s59mz/PocketSDR-AFS/FE_4CH/HW/v3.0/pocket_sdr_v3.0_sch.pdf

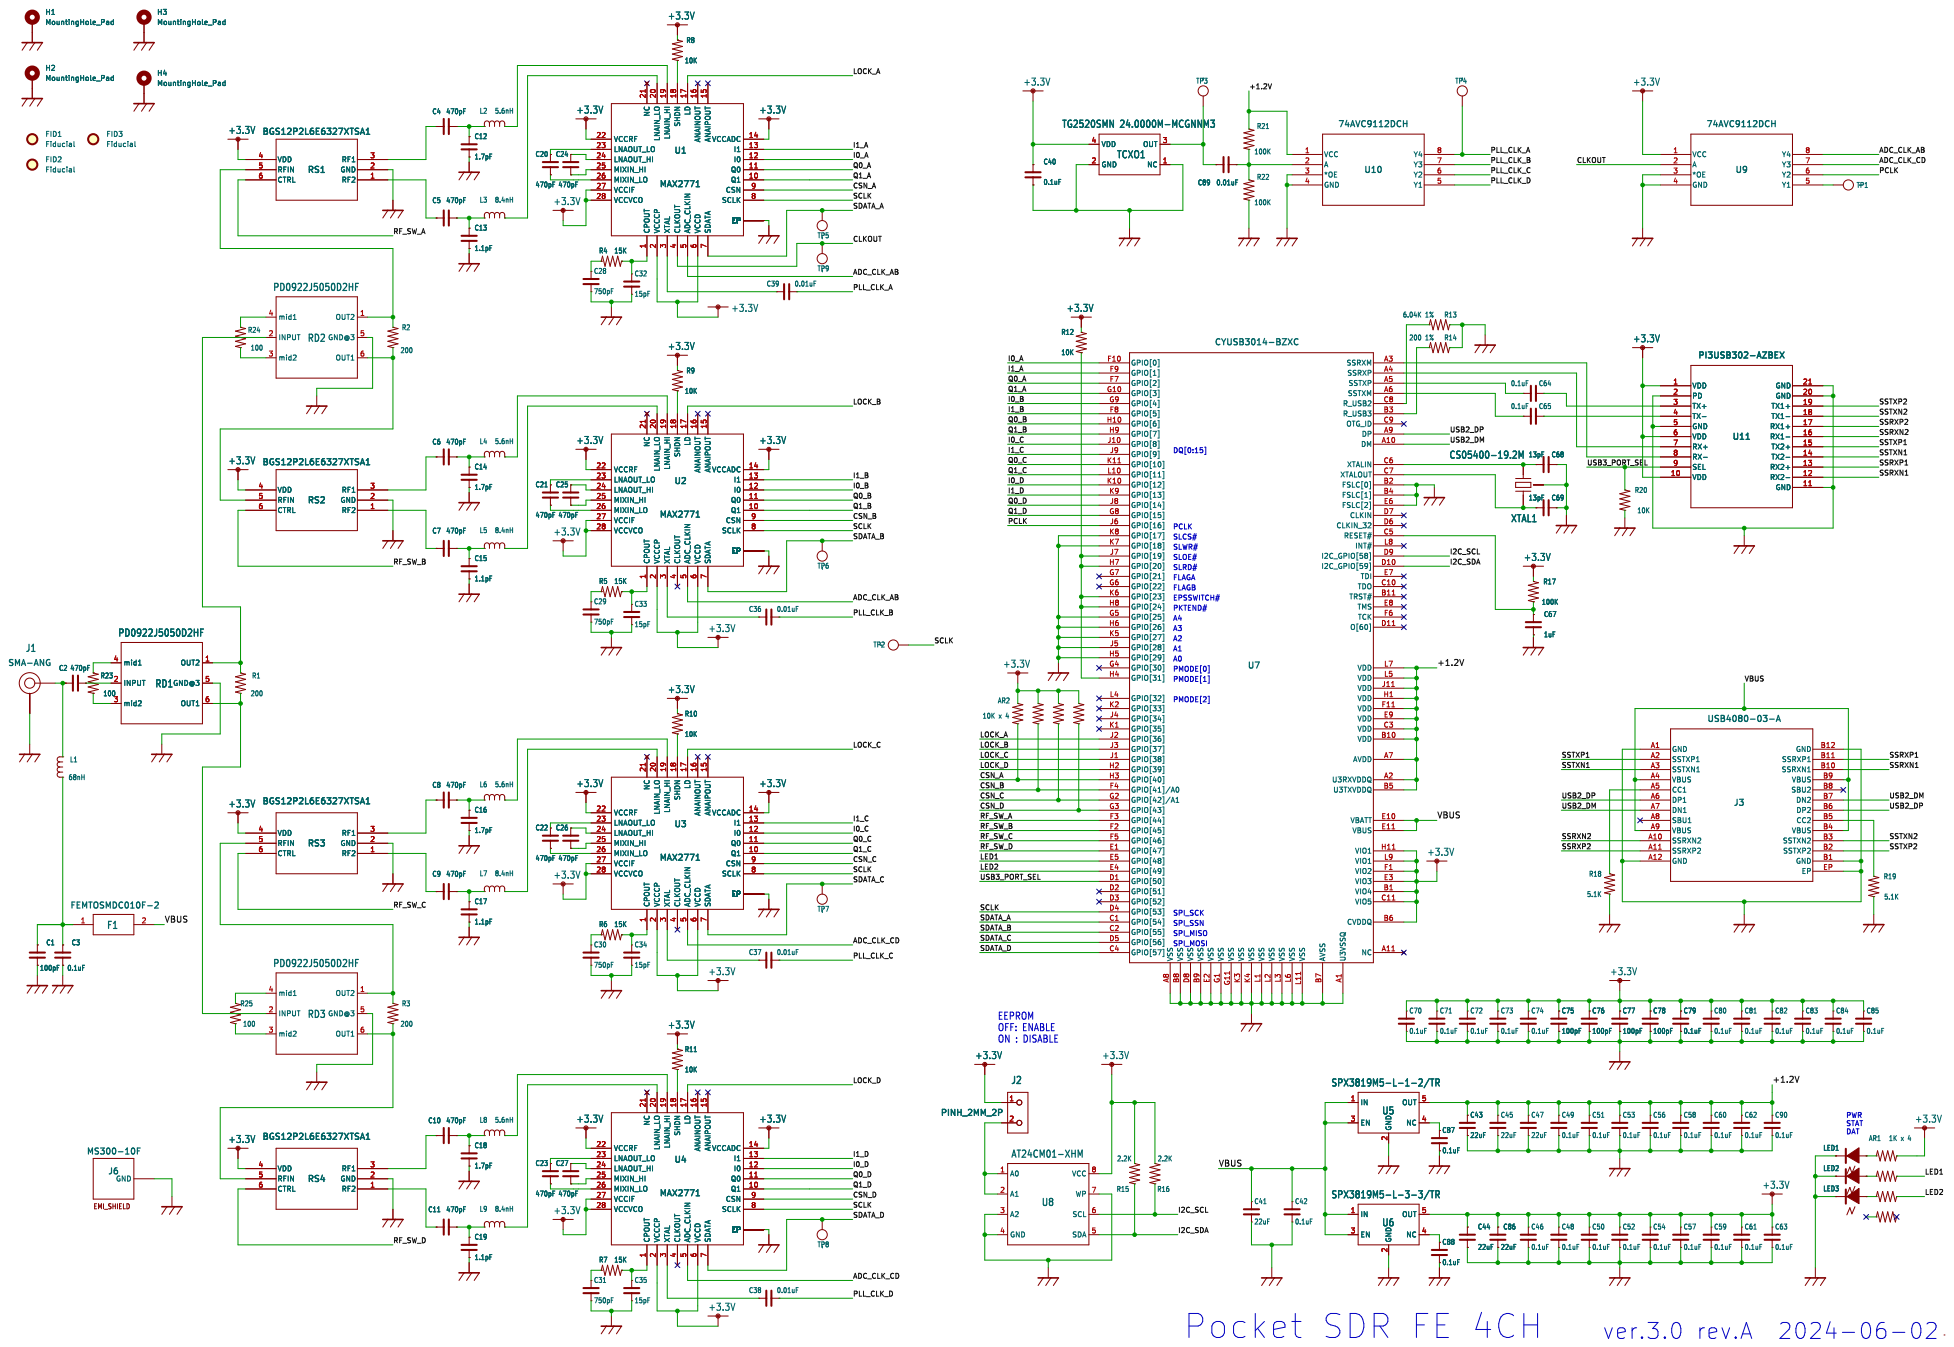
[picture p1: page 1]

SLRD# SLOE# EPSSWITCH# Pocket SDR FE 4CH
