s59mz/PocketSDR-AFS/FE_4CH/HW/v3.0/v3.0.kicad_pcb

## KiCad design FE_4CH/HW/v3.0/v3.0.kicad_pcb (2026-01-03)

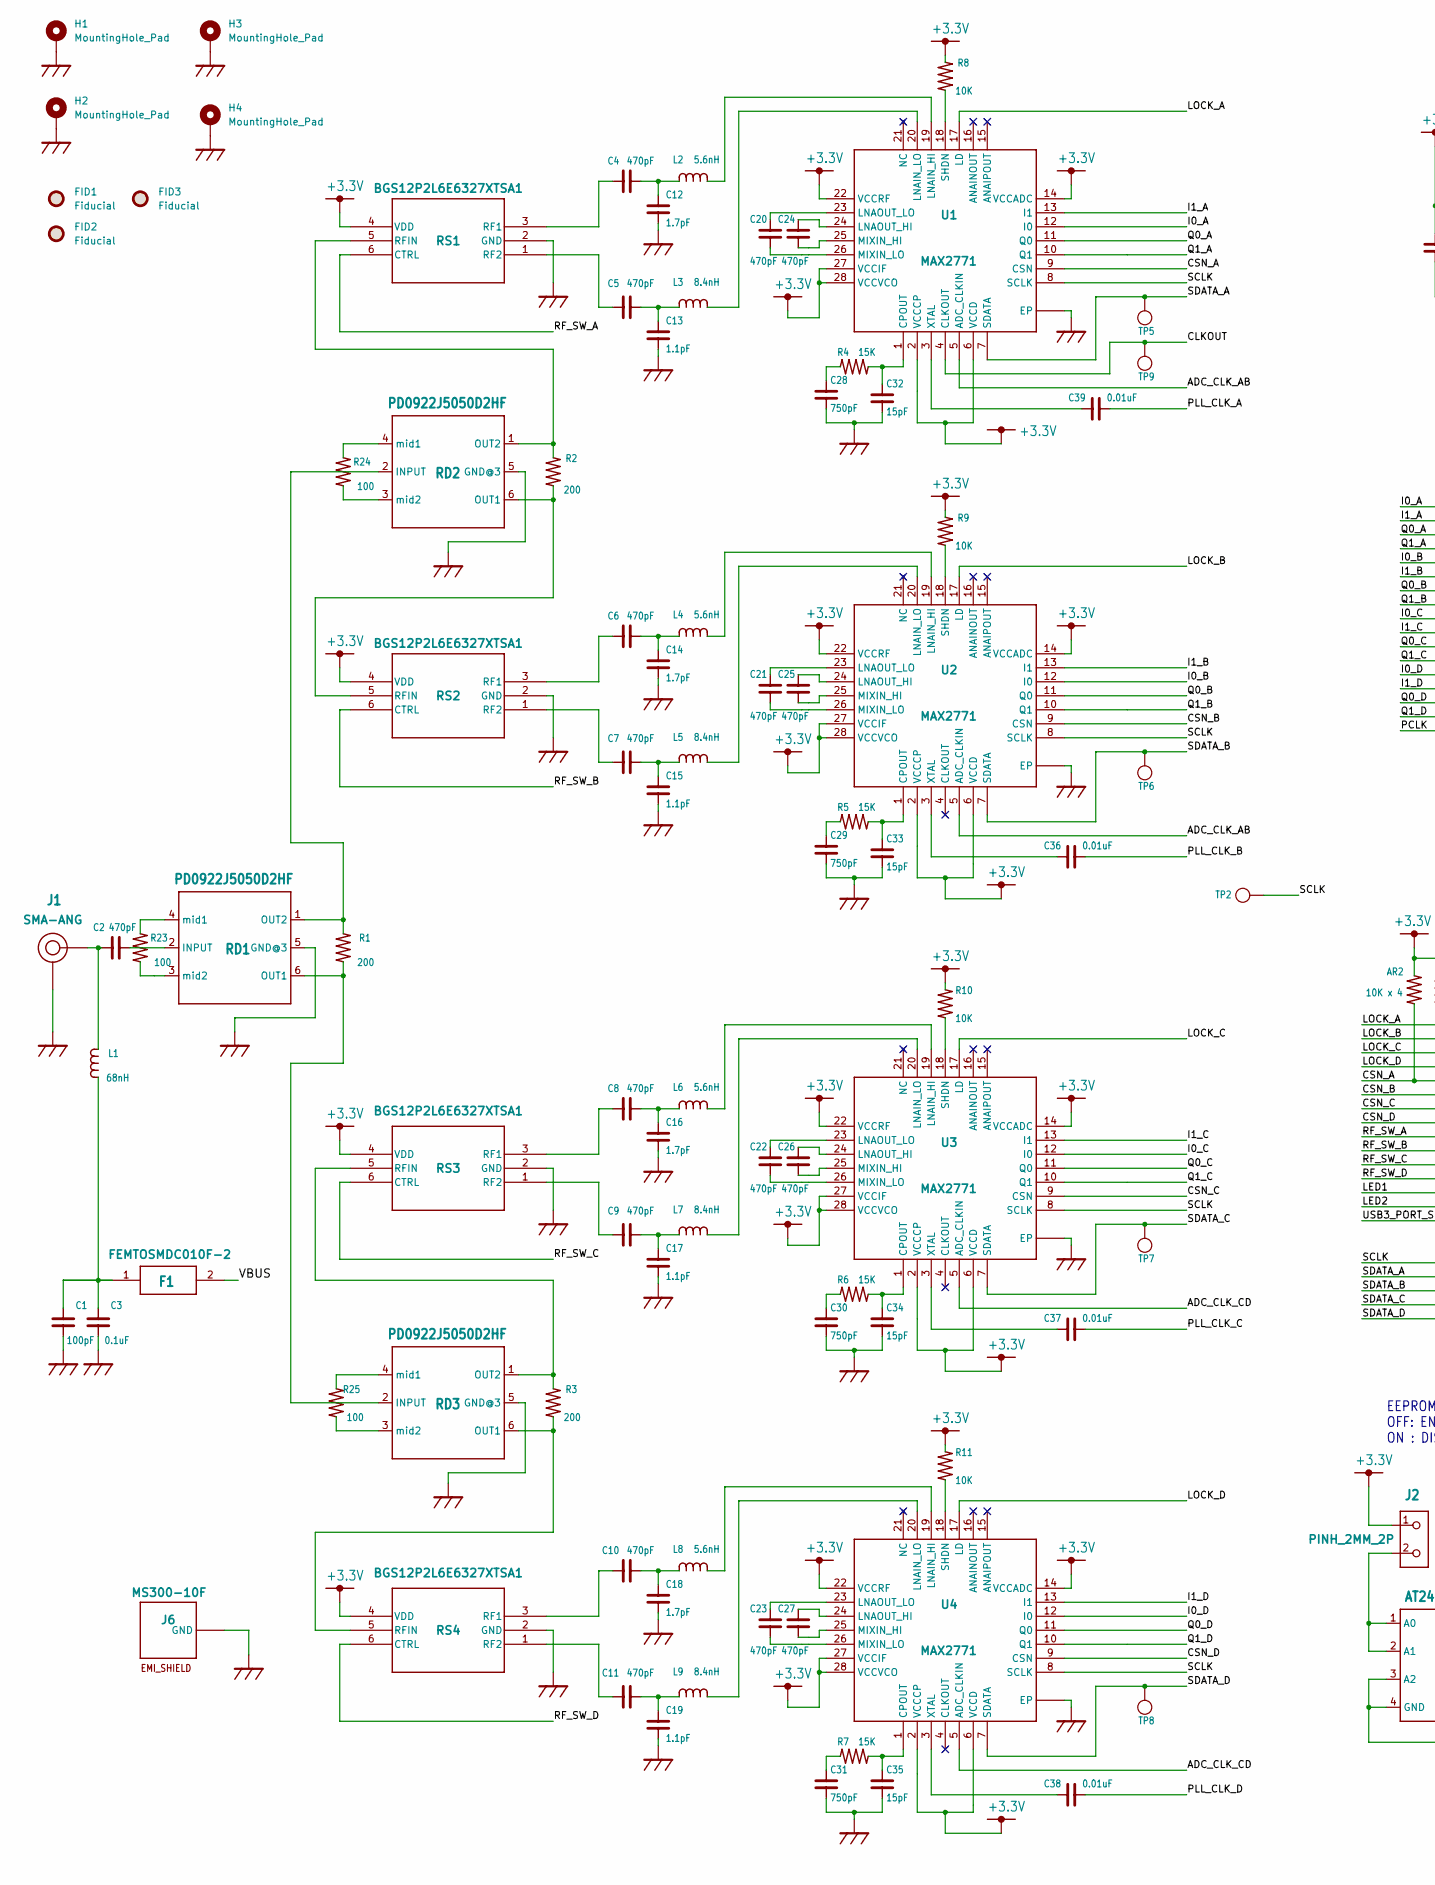
[picture p2: schematic v3.0.kicad_sch, part in row 1, column 1]

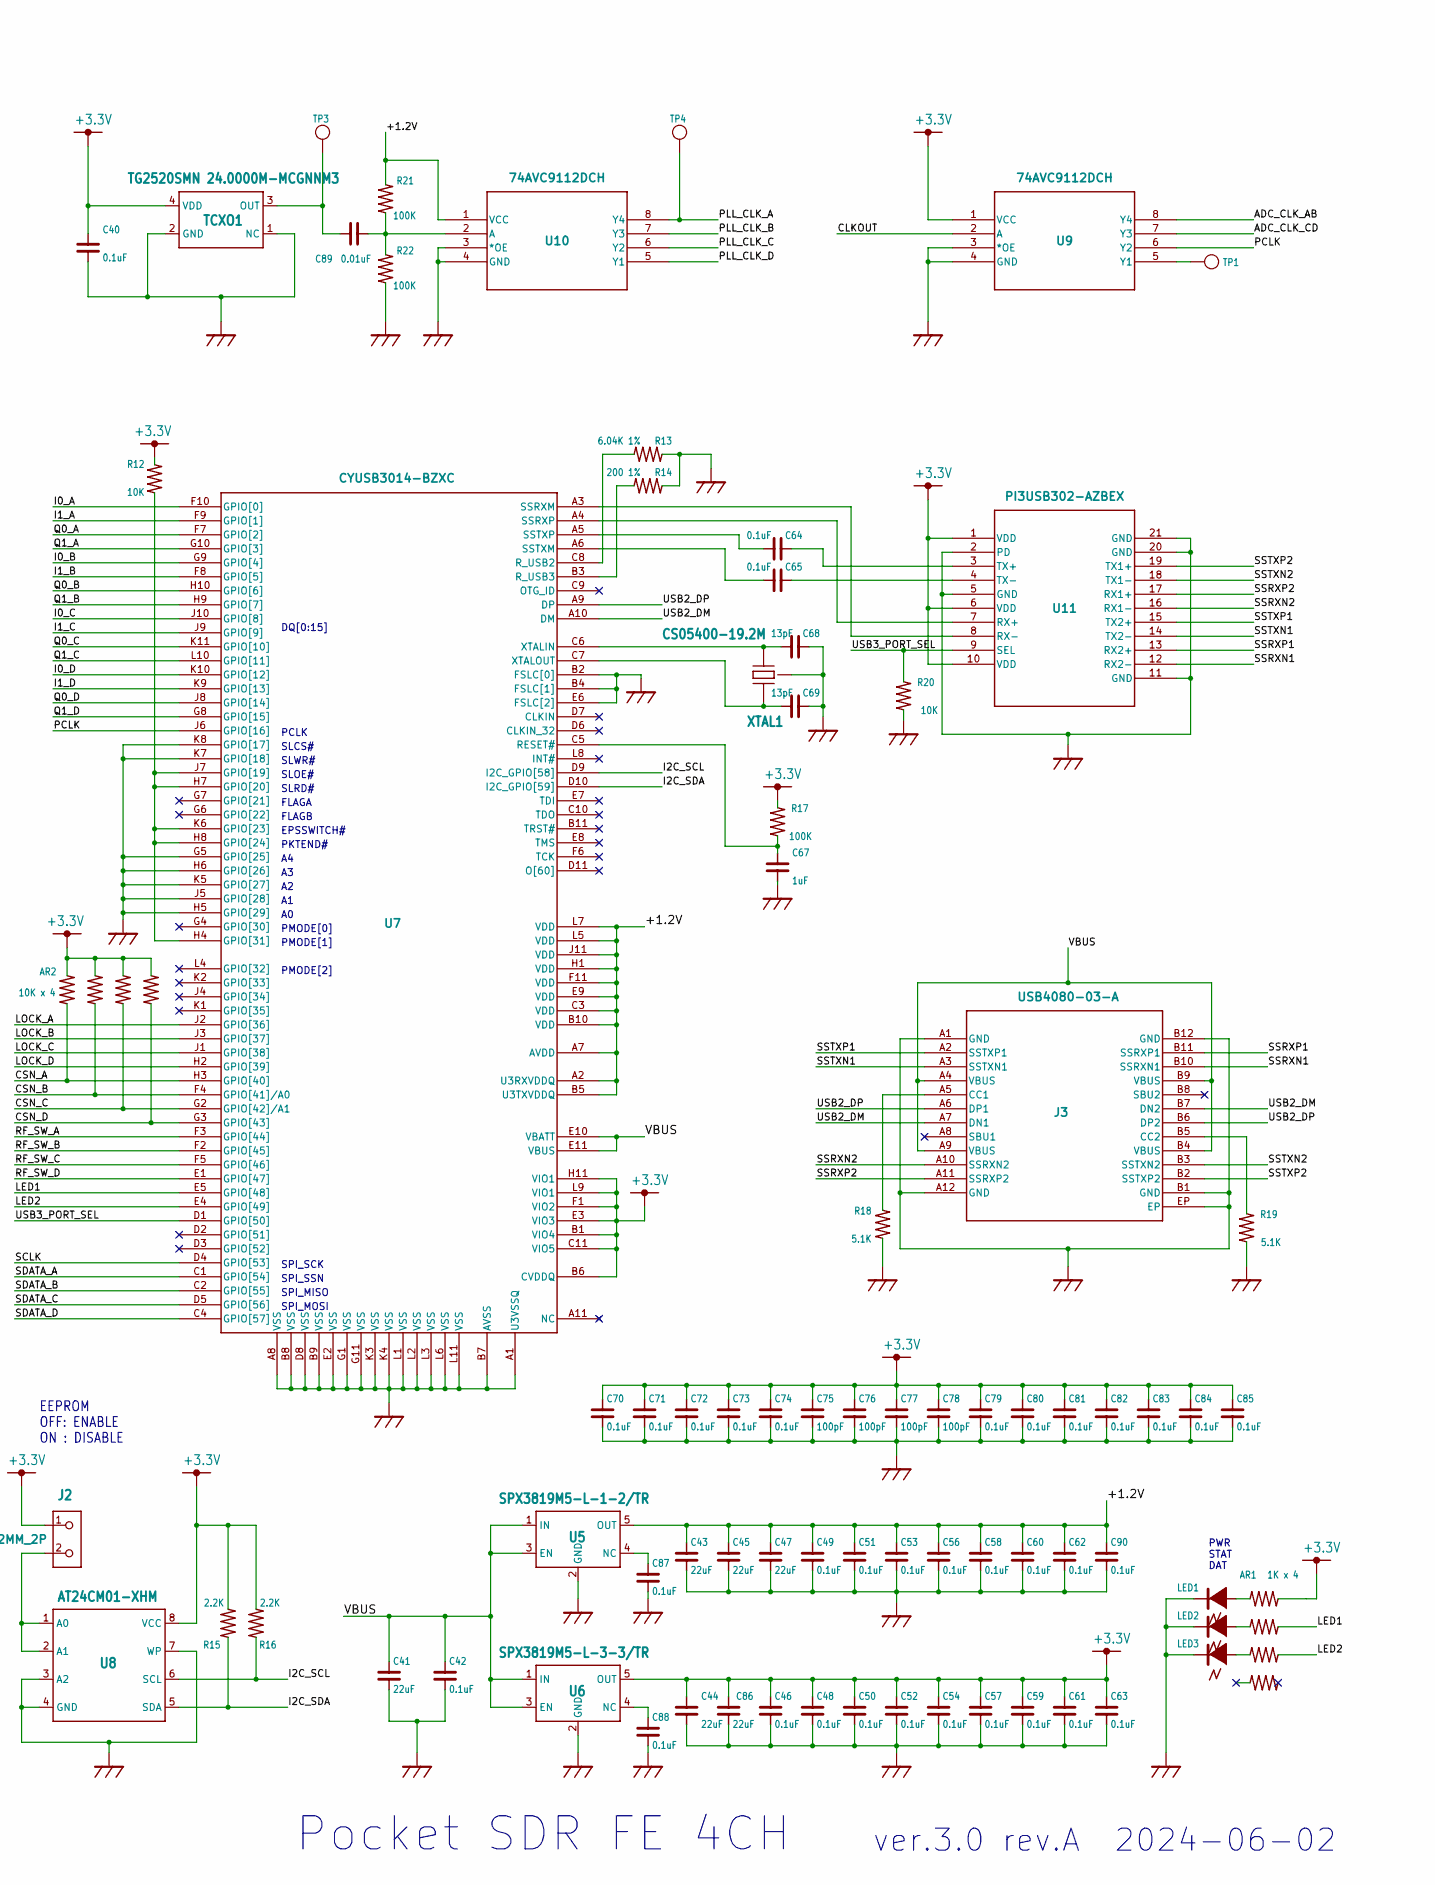
[picture p3: schematic v3.0.kicad_sch, part in row 1, column 2]

Parts:
AR1: 1K x 4; EXB28V
AR2: 10K x 4; EXB28V
C1, C75, C76, C77, C78: 100pF; C1005
C2, C4, C5, C6, C7, C8, C9, C10, C11, C20, C21, C22, C23, C24, C25, C26, C27: 470pF; C1005
C3, C40, C42, C46, C48, C49, C50, C51, C52, C53, C54, C56, C57, C58, C59, C60, C61, C62, C63, C64, C65, C70, C71, C72, C73, C74, C79, C80, C81, C82, C83, C84, C85, C87, C88, C90: 0.1uF; C1005
C12, C14, C16, C18: 1.7pF; C1005
C13, C15, C17, C19: 1.1pF; C1005
C28, C29, C30, C31: 750pF; C1005
C32, C33, C34, C35: 15pF; C1005
C36, C37, C38, C39, C89: 0.01uF; C1005
C41, C43, C44, C45, C47, C86: 22uF; C1608
C67: 1uF; C1005
C68, C69: 13pF; C1005
F1: FEMTOSMDC010F-2; C1608
FID1, FID2, FID3: Fiducial; Fiducial_0.75mm_Mask1.5mm
H1, H2, H3, H4: MountingHole_Pad; MountingHole_2.2mm_M2_DIN965_Pad
J1: SMA-ANG
J2: PINH_2MM_2P; PINH-2MM-2P
J3: USB4080-03-A; USB4080-03-A_GCT
J6: MS300-10F
L1: 68nH; C1608
L2, L4, L6, L8: 5.6nH; C1005
L3, L5, L7, L9: 8.4nH; C1005
LED1, LED2, LED3: LED1608; LED_1608
R1, R2, R3: 200; C1005
R4, R5, R6, R7: 15K; C1005
R8, R9, R10, R11, R12, R20: 10K; C1005
R13: 6.04K 1%; C1005
R14: 200 1%; C1005
R15, R16: 2.2K; C1005
R17, R21, R22: 100K; C1005
R18, R19: 5.1K; C1005
R23, R24, R25: 100; C1005
RD1, RD2, RD3: PD0922J5050D2HF; RF_DIV
RS1, RS2, RS3, RS4: BGS12P2L6E6327XTSA1; PG-TSLP-6-4_INF
TCXO1: TG2520SMN 24.0000M-MCGNNM3; TCXO
TP1, TP2, TP3, TP4, TP5, TP6, TP7, TP8, TP9: TP0.5
U1, U2, U3, U4: MAX2771; TQFN28
U5: SPX3819M5-L-1-2/TR; SOT23
U6: SPX3819M5-L-3-3/TR; SOT23
U7: CYUSB3014-BZXC; BGA-121
U8: AT24CM01-XHM; TSSOP_8P
U9, U10: 74AVC9112DCH; VSSOP8_SOT765-1_NEX
U11: PI3USB302-AZBEX; 20TQFN-ZB_PI3USB302-A_DIO
XTAL1: CS05400-19.2M; XTAL_SMD

Connections:
+3.3V: AR1.2, AR2.2, AR2.4, AR2.6, AR2.8, C40.1, C44.1, C46.1, C48.1, C50.1, C52.1, C54.1, C57.1, C59.1, C61.1, C63.1, C70.1, C71.1, C72.1, C73.1, C74.1, C75.1, C76.1, C77.1, C78.1, C79.1, C80.1, C81.1, C82.1, C83.1, C84.1, C85.1, C86.1, J2.1, R8.2, R9.2, R10.2, R11.2, R12.1, R15.2, R16.2, R17.2, RS1.4 (VDD), RS2.4 (VDD), RS3.4 (VDD), RS4.4 (VDD), TCXO1.4 (VDD), U1.2 (VCCCP), U1.6 (VCCD), U1.14 (VCCADC), U1.22 (VCCRF), U1.27 (VCCIF), U1.28 (VCCVCO), U2.2 (VCCCP), U2.6 (VCCD), U2.14 (VCCADC), U2.22 (VCCRF), U2.27 (VCCIF), U2.28 (VCCVCO), U3.2 (VCCCP), U3.6 (VCCD), U3.14 (VCCADC), U3.22 (VCCRF), U3.27 (VCCIF), U3.28 (VCCVCO), U4.2 (VCCCP), U4.6 (VCCD), U4.14 (VCCADC), U4.22 (VCCRF), U4.27 (VCCIF), U4.28 (VCCVCO), U6.5 (OUT), U7.B1 (VIO4), U7.B6 (CVDDQ), U7.C11 (VIO5), U7.E3 (VIO3), U7.F1 (VIO2), U7.H11 (VIO1), U7.L9 (VIO1), U8.8 (VCC), U9.1 (VCC), U11.1 (VDD), U11.6 (VDD), U11.10 (VDD)
/+1.2V: C43.1, C45.1, C47.1, C49.1, C51.1, C53.1, C56.1, C58.1, C60.1, C62.1, C90.1, R21.1, U5.5 (OUT), U7.A2 (U3RXVDDQ), U7.A7 (AVDD), U7.B5 (U3TXVDDQ), U7.B10 (VDD), U7.C3 (VDD), U7.E9 (VDD), U7.F11 (VDD), U7.H1 (VDD), U7.J11 (VDD), U7.L5 (VDD), U7.L7 (VDD), U10.1 (VCC)
/ADC_CLK_AB: U1.5 (ADC_CLKIN), U2.5 (ADC_CLKIN), U9.8 (Y4)
/ADC_CLK_CD: U3.5 (ADC_CLKIN), U4.5 (ADC_CLKIN), U9.7 (Y3)
/CLKOUT: TP9.1, U1.4 (CLKOUT), U9.2 (A)
/CSN_A: AR2.1, U1.9 (CSN), U7.H3 (GPIO[40])
/CSN_B: AR2.3, U2.9 (CSN), U7.F4 (GPIO[41]/A0)
/CSN_C: AR2.5, U3.9 (CSN), U7.G2 (GPIO[42]/A1)
/CSN_D: AR2.7, U4.9 (CSN), U7.G3 (GPIO[43])
/I0_A: U1.12 (I0), U7.F10 (GPIO[0])
/I0_B: U2.12 (I0), U7.G9 (GPIO[4])
/I0_C: U3.12 (I0), U7.J10 (GPIO[8])
/I0_D: U4.12 (I0), U7.K10 (GPIO[12])
/I1_A: U1.13 (I1), U7.F9 (GPIO[1])
/I1_B: U2.13 (I1), U7.F8 (GPIO[5])
/I1_C: U3.13 (I1), U7.J9 (GPIO[9])
/I1_D: U4.13 (I1), U7.K9 (GPIO[13])
/I2C_SCL: R16.1, U7.D9 (I2C_GPIO[58]), U8.6 (SCL)
/I2C_SDA: R15.1, U7.D10 (I2C_GPIO[59]), U8.5 (SDA)
/LED1: AR1.4, U7.E5 (GPIO[48])
/LED2: AR1.6, U7.E4 (GPIO[49])
/LOCK_A: U1.17 (LD), U7.J2 (GPIO[36])
/LOCK_B: U2.17 (LD), U7.J3 (GPIO[37])
/LOCK_C: U3.17 (LD), U7.J1 (GPIO[38])
/LOCK_D: U4.17 (LD), U7.H2 (GPIO[39])
/PCLK: U7.J6 (GPIO[16]), U9.6 (Y2)
/PLL_CLK_A: C39.1, TP4.1, U10.8 (Y4)
/PLL_CLK_B: C36.1, U10.7 (Y3)
/PLL_CLK_C: C37.1, U10.6 (Y2)
/PLL_CLK_D: C38.1, U10.5 (Y1)
/Q0_A: U1.11 (Q0), U7.F7 (GPIO[2])
/Q0_B: U2.11 (Q0), U7.H10 (GPIO[6])
/Q0_C: U3.11 (Q0), U7.K11 (GPIO[10])
/Q0_D: U4.11 (Q0), U7.J8 (GPIO[14])
/Q1_A: U1.10 (Q1), U7.G10 (GPIO[3])
/Q1_B: U2.10 (Q1), U7.H9 (GPIO[7])
/Q1_C: U3.10 (Q1), U7.L10 (GPIO[11])
/Q1_D: U4.10 (Q1), U7.G8 (GPIO[15])
/RF_SW_A: RS1.6 (CTRL), U7.F3 (GPIO[44])
/RF_SW_B: RS2.6 (CTRL), U7.F2 (GPIO[45])
/RF_SW_C: RS3.6 (CTRL), U7.F5 (GPIO[46])
/RF_SW_D: RS4.6 (CTRL), U7.E1 (GPIO[47])
/SCLK: TP2.1, U1.8 (SCLK), U2.8 (SCLK), U3.8 (SCLK), U4.8 (SCLK), U7.D4 (GPIO[53])
/SDATA_A: TP5.1, U1.7 (SDATA), U7.C1 (GPIO[54])
/SDATA_B: TP6.1, U2.7 (SDATA), U7.C2 (GPIO[55])
/SDATA_C: TP7.1, U3.7 (SDATA), U7.D5 (GPIO[56])
/SDATA_D: TP8.1, U4.7 (SDATA), U7.C4 (GPIO[57])
/SSRXN1: J3.B10 (SSRXN1), U11.12 (RX2-)
/SSRXN2: J3.A10 (SSRXN2), U11.16 (RX1-)
/SSRXP1: J3.B11 (SSRXP1), U11.13 (RX2+)
/SSRXP2: J3.A11 (SSRXP2), U11.17 (RX1+)
/SSTXN1: J3.A3 (SSTXN1), U11.14 (TX2-)
/SSTXN2: J3.B3 (SSTXN2), U11.18 (TX1-)
/SSTXP1: J3.A2 (SSTXP1), U11.15 (TX2+)
/SSTXP2: J3.B2 (SSTXP2), U11.19 (TX1+)
/USB2_DM: J3.A7 (DN1), J3.B7 (DN2), U7.A10 (DM)
/USB2_DP: J3.A6 (DP1), J3.B6 (DP2), U7.A9 (DP)
/USB3_PORT_SEL: R20.2, U7.D1 (GPIO[50]), U11.9 (SEL)
/VBUS: C41.1, C42.1, F1.2, J3.A4 (VBUS), J3.A9 (VBUS), J3.B4 (VBUS), J3.B9 (VBUS), U5.1 (IN), U5.3 (EN), U6.1 (IN), U6.3 (EN), U7.E10 (VBATT), U7.E11 (VBUS)
GND: C1.1, C3.1, C12.1, C13.1, C14.1, C15.1, C16.1, C17.1, C18.1, C19.1, C28.2, C29.2, C30.2, C31.2, C32.2, C33.2, C34.2, C35.2, C40.2, C41.2, C42.2, C43.2, C44.2, C45.2, C46.2, C47.2, C48.2, C49.2, C50.2, C51.2, C52.2, C53.2, C54.2, C56.2, C57.2, C58.2, C59.2, C60.2, C61.2, C62.2, C63.2, C67.2, C68.1, C69.1, C70.2, C71.2, C72.2, C73.2, C74.2, C75.2, C76.2, C77.2, C78.2, C79.2, C80.2, C81.2, C82.2, C83.2, C84.2, C85.2, C86.2, C87.2, C88.2, C90.2, H1.1, H2.1, H3.1, H4.1, J1.P2 (GND), J1.P3 (GND), J1.P4 (GND), J1.P5 (GND), J3.A1 (GND), J3.A12 (GND), J3.B1 (GND), J3.B12 (GND), J3.EP, J6.P1 (GND), LED1.2, LED2.2, LED3.2, R13.1, R14.1, R18.1, R19.1, R20.1, R22.2, RD1.5 (GND@3), RD2.5 (GND@3), RD3.5 (GND@3), RS1.2 (GND), RS2.2 (GND), RS3.2 (GND), RS4.2 (GND), TCXO1.1 (NC), TCXO1.2 (GND), U1.C1 (EP), U1.C2 (EP), U1.C3 (EP), U1.C4 (EP), U1.EP, U1.V1 (EP), U1.V2 (EP), U1.V3 (EP), U1.V4 (EP), U1.V5 (EP), U1.V6 (EP), U1.V7 (EP), U1.V8 (EP), U1.V9 (EP), U2.C1 (EP), U2.C2 (EP), U2.C3 (EP), U2.C4 (EP), U2.EP, U2.V1 (EP), U2.V2 (EP), U2.V3 (EP), U2.V4 (EP), U2.V5 (EP), U2.V6 (EP), U2.V7 (EP), U2.V8 (EP), U2.V9 (EP), U3.C1 (EP), U3.C2 (EP), U3.C3 (EP), U3.C4 (EP), U3.EP, U3.V1 (EP), U3.V2 (EP), U3.V3 (EP), U3.V4 (EP), U3.V5 (EP), U3.V6 (EP), U3.V7 (EP), U3.V8 (EP), U3.V9 (EP), U4.C1 (EP), U4.C2 (EP), U4.C3 (EP), U4.C4 (EP), U4.EP, U4.V1 (EP), U4.V2 (EP), U4.V3 (EP), U4.V4 (EP), U4.V5 (EP), U4.V6 (EP), U4.V7 (EP), U4.V8 (EP), U4.V9 (EP), U5.2 (GND), U6.2 (GND), U7.A1 (U3VSSQ), U7.A8 (VSS), U7.B2 (FSLC[0]), U7.B4 (FSLC[1]), U7.B7 (AVSS), U7.B8 (VSS), U7.B9 (VSS), U7.D8 (VSS), U7.E2 (VSS), U7.E6 (FSLC[2]), U7.G1 (VSS), U7.G5 (GPIO[25]), U7.G11 (VSS), U7.H5 (GPIO[29]), U7.H6 (GPIO[26]), U7.J5 (GPIO[28]), U7.K3 (VSS), U7.K4 (VSS), U7.K5 (GPIO[27]), U7.K7 (GPIO[18]), U7.K8 (GPIO[17]), U7.L1 (VSS), U7.L2 (VSS), U7.L3 (VSS), U7.L6 (VSS), U7.L11 (VSS), U8.3 (A2), U8.4 (GND), U8.7 (WP), U9.3 (*OE), U9.4 (GND), U10.3 (*OE), U10.4 (GND), U11.2 (PD), U11.5 (GND), U11.11 (GND), U11.20 (GND), U11.21 (GND), XTAL1.P2 (GND), XTAL1.P4 (GND)
unnamed: AR1.1, LED1.1 (+)
unnamed: AR1.3, LED2.1 (+)
unnamed: AR1.5, LED3.1 (+)
unnamed: C1.2, C3.2, F1.1, L1.1
unnamed: C2.1, J1.P1 (RF), L1.2
unnamed: J2.2, U8.1 (A0), U8.2 (A1)
unnamed: J3.A5 (CC1), R18.2
unnamed: J3.B5 (CC2), R19.2
unnamed: C4.2, C12.2, L2.1
unnamed: L2.2, U1.19 (LNAIN_HI)
unnamed: C5.2, C13.2, L3.1
unnamed: L3.2, U1.20 (LNAIN_LO)
unnamed: C6.2, C14.2, L4.1
unnamed: L4.2, U2.19 (LNAIN_HI)
unnamed: C7.2, C15.2, L5.1
unnamed: L5.2, U2.20 (LNAIN_LO)
unnamed: C8.2, C16.2, L6.1
unnamed: L6.2, U3.19 (LNAIN_HI)
unnamed: C9.2, C17.2, L7.1
unnamed: L7.2, U3.20 (LNAIN_LO)
unnamed: C10.2, C18.2, L8.1
unnamed: L8.2, U4.19 (LNAIN_HI)
unnamed: C11.2, C19.2, L9.1
unnamed: L9.2, U4.20 (LNAIN_LO)
unnamed: R1.1, RD1.6 (OUT1), RD3.2 (INPUT)
unnamed: R1.2, RD1.1 (OUT2), RD2.2 (INPUT)
unnamed: R2.1, RD2.6 (OUT1), RS2.5 (RFIN)
unnamed: R2.2, RD2.1 (OUT2), RS1.5 (RFIN)
unnamed: R3.1, RD3.6 (OUT1), RS4.5 (RFIN)
unnamed: R3.2, RD3.1 (OUT2), RS3.5 (RFIN)
unnamed: C28.1, R4.1
unnamed: C32.1, R4.2, U1.1 (CPOUT)
unnamed: C29.1, R5.1
unnamed: C33.1, R5.2, U2.1 (CPOUT)
unnamed: C30.1, R6.1
unnamed: C34.1, R6.2, U3.1 (CPOUT)
unnamed: C31.1, R7.1
unnamed: C35.1, R7.2, U4.1 (CPOUT)
unnamed: R8.1, U1.18 (SHDN)
unnamed: R9.1, U2.18 (SHDN)
unnamed: R10.1, U3.18 (SHDN)
unnamed: R11.1, U4.18 (SHDN)
unnamed: R12.2, U7.H4 (GPIO[31]), U7.H7 (GPIO[20]), U7.H8 (GPIO[24]), U7.J7 (GPIO[19]), U7.K6 (GPIO[23])
unnamed: R13.2, U7.C8 (R_USB2)
unnamed: R14.2, U7.B3 (R_USB3)
unnamed: C67.1, R17.1, U7.C5 (RESET#)
unnamed: C89.2, R21.2, R22.1, U10.2 (A)
unnamed: R23.1, RD1.3 (mid2)
unnamed: R23.2, RD1.4 (mid1)
unnamed: R24.1, RD2.3 (mid2)
unnamed: R24.2, RD2.4 (mid1)
unnamed: R25.1, RD3.3 (mid2)
unnamed: R25.2, RD3.4 (mid1)
unnamed: C2.2, RD1.2 (INPUT)
unnamed: C4.1, RS1.3 (RF1)
unnamed: C5.1, RS1.1 (RF2)
unnamed: C6.1, RS2.3 (RF1)
unnamed: C7.1, RS2.1 (RF2)
unnamed: C8.1, RS3.3 (RF1)
unnamed: C9.1, RS3.1 (RF2)
unnamed: C10.1, RS4.3 (RF1)
unnamed: C11.1, RS4.1 (RF2)
unnamed: C89.1, TCXO1.3 (OUT), TP3.1
unnamed: C24.1, U1.24 (LNAOUT_HI)
unnamed: C20.1, U1.23 (LNAOUT_LO)
unnamed: C24.2, U1.25 (MIXIN_HI)
unnamed: C20.2, U1.26 (MIXIN_LO)
unnamed: C39.2, U1.3 (XTAL)
unnamed: C25.1, U2.24 (LNAOUT_HI)
unnamed: C21.1, U2.23 (LNAOUT_LO)
unnamed: C25.2, U2.25 (MIXIN_HI)
unnamed: C21.2, U2.26 (MIXIN_LO)
unnamed: C36.2, U2.3 (XTAL)
unnamed: C26.1, U3.24 (LNAOUT_HI)
unnamed: C22.1, U3.23 (LNAOUT_LO)
unnamed: C26.2, U3.25 (MIXIN_HI)
unnamed: C22.2, U3.26 (MIXIN_LO)
unnamed: C37.2, U3.3 (XTAL)
unnamed: C27.1, U4.24 (LNAOUT_HI)
unnamed: C23.1, U4.23 (LNAOUT_LO)
unnamed: C27.2, U4.25 (MIXIN_HI)
unnamed: C23.2, U4.26 (MIXIN_LO)
unnamed: C38.2, U4.3 (XTAL)
unnamed: C87.1, U5.4 (NC)
unnamed: C88.1, U6.4 (NC)
unnamed: C65.2, U7.A6 (SSTXM)
unnamed: C64.2, U7.A5 (SSTXP)
unnamed: C68.2, U7.C6 (XTALIN), XTAL1.P1 (XTAL1)
unnamed: C69.2, U7.C7 (XTALOUT), XTAL1.P3 (XTAL2)
unnamed: TP1.1, U9.5 (Y1)
unnamed: U7.A4 (SSRXP), U11.7 (RX+)
unnamed: U7.A3 (SSRXM), U11.8 (RX-)
unnamed: C64.1, U11.3 (TX+)
unnamed: C65.1, U11.4 (TX-)

Notes on the sheet:
PCLK
EPSSWITCH#
SPI_SSN
PMODE[1]
DQ[0:15]
Pocket SDR FE 4CH
PMODE[0]
EEPROM OFF: ENABLE ON : DISABLE
SPI_SCK
SPI_MOSI
SLRD#
SLOE#
SLCS#
PMODE[2]
PWR STAT DAT
SLWR#
PKTEND#
ver.3.0 rev.A 2024-06-02
SPI_MISO
FLAGA
FLAGB

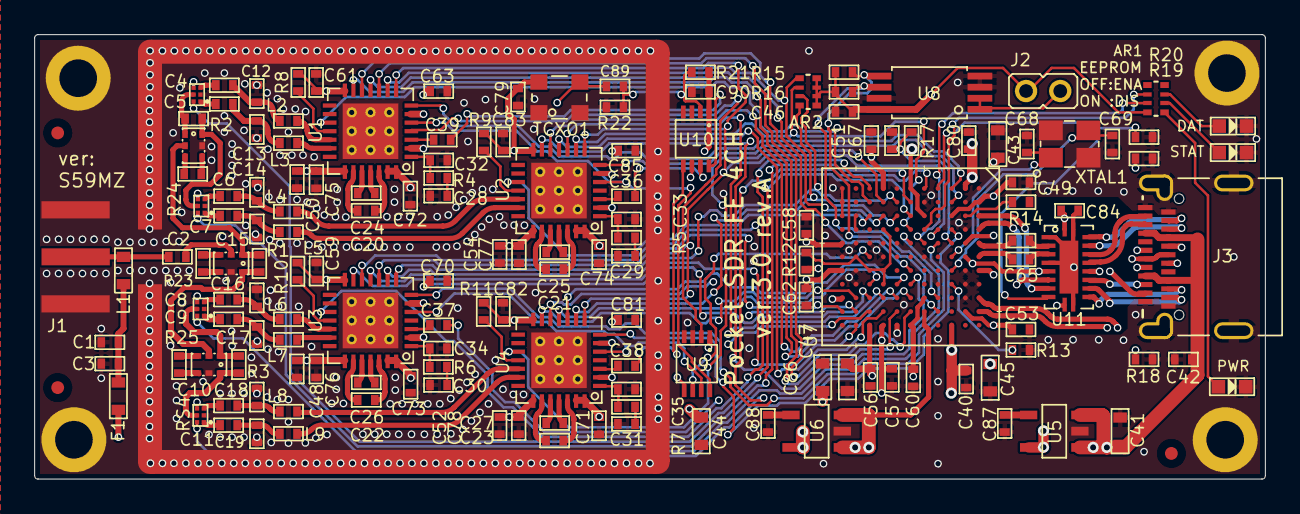
[picture p4: board v3.0.kicad_pcb from above]

Board: 4 copper layers, 72.0 x 26.0 mm, 168 parts (0 on the bottom side), 154 nets.
